kaymantex68/autocad_nagrev_vann_tatarstan/1.pdf

## Обогрев ванн

схема электрическая принципиальная пульта управления

Тамбов 2020г.
