kaymantex68/autocad_nagrev_vann_tatarstan/нагрев ванн.pdf

# Обогрев ванн

## схема электрическая принципиальная пульта управления

Тамбов 2020г.

1 | 2 | 3 | 4 | 5 | 6 | 7 | 8 | 9 | 10

Инв.N подл. Подпись и дата Взам.инв. N Формат А3 Изм Кол.уч Лист N док. Подп. Дата Лист Ввод ~380VA Wmax S кабеля 10мм2 Ванна I Индикация работа нагревателя I Индикация работа насоса I Ванна II Индикация работа нагревателя II Индикация работа насоса II Нагреватель 220VAC 12 кВт Насос 380VAC 0,75 кВт Нагреватель 220VAC 12 кВт Насос 380VAC 0,75 кВт Обогрев ванн 2

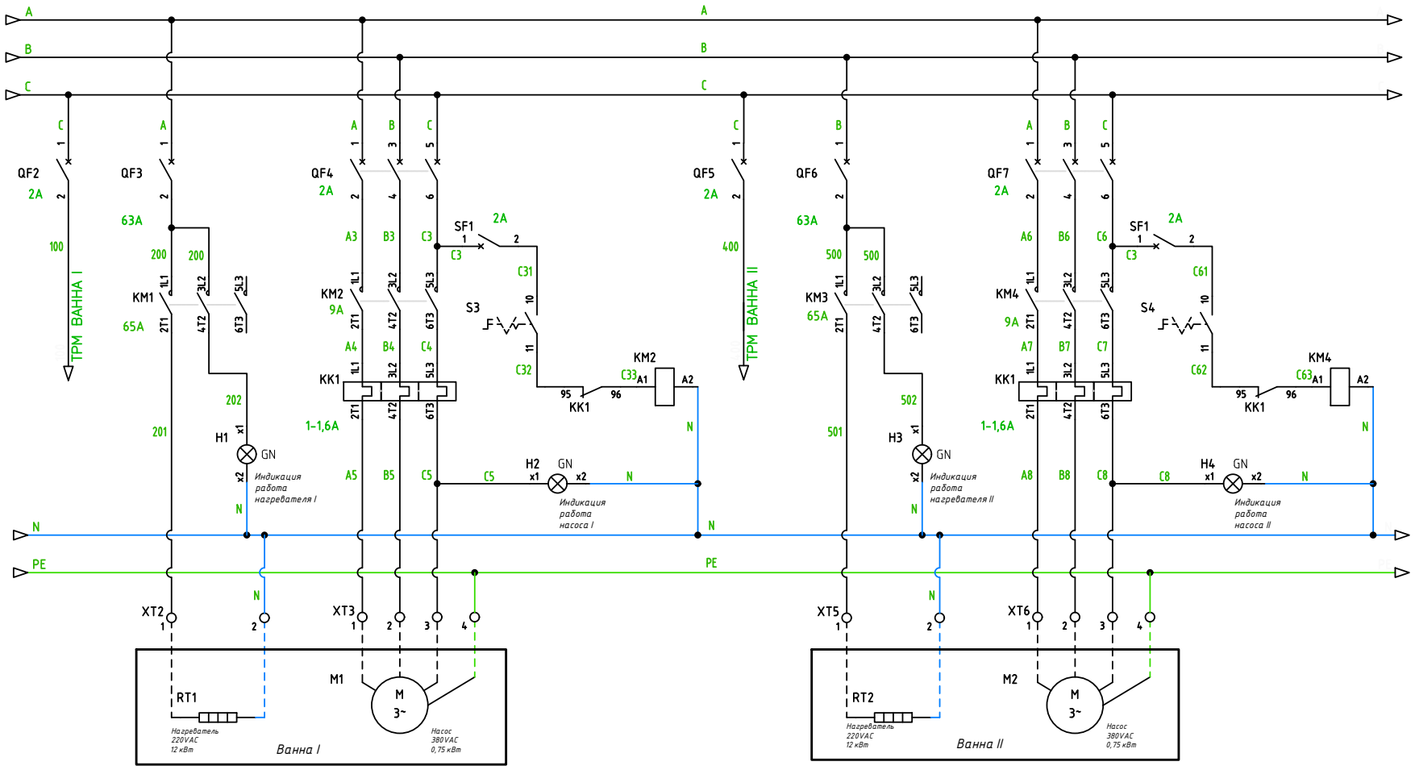
[picture p1: figure]

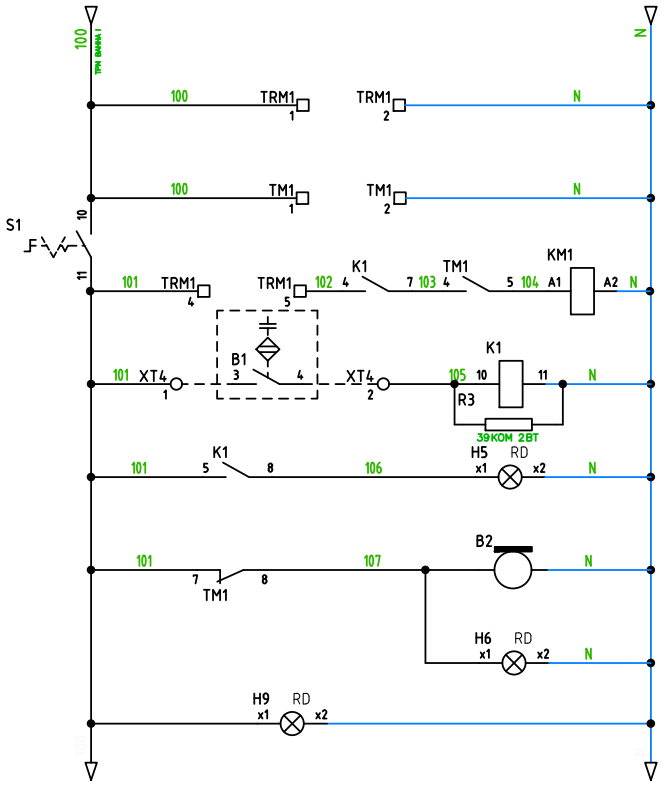
[picture p2: figure]
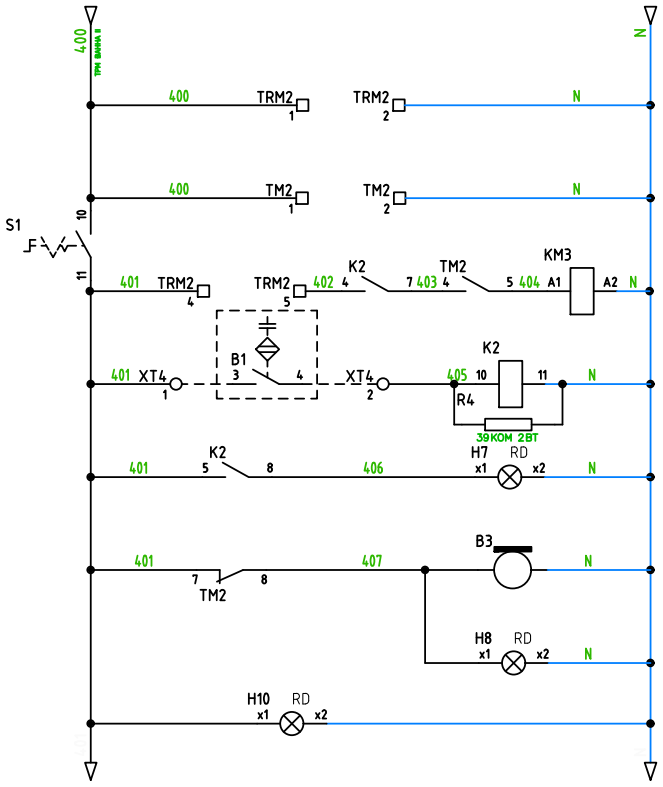
[picture p3: figure]

Инв.N подл. Подпись и дата Взам.инв. N Формат А3 Изм Кол.уч Лист N док. Подп. Дата Лист Питание: ТРМ 1 Питание: таймер 1 Нагрев: ванна 1 Емкостный датчик: ванна 1 Оповещение: уровень жидкости ванна 1 Звуковое оповещение: окончание работы Световое оповещение: окончание работы Ванна I Питание: ТРМ 2 Питание: таймер 2 Нагрев: ванна 2 Емкостный датчик: ванна 2 Оповещение: уровень жидкости ванна 2 Звуковое оповещение: окончание работы Световое оповещение: окончание работы Ванна II Обогрев ванн 3 Состояние: нагрев вкл/выкл Состояние: нагрев вкл/выкл

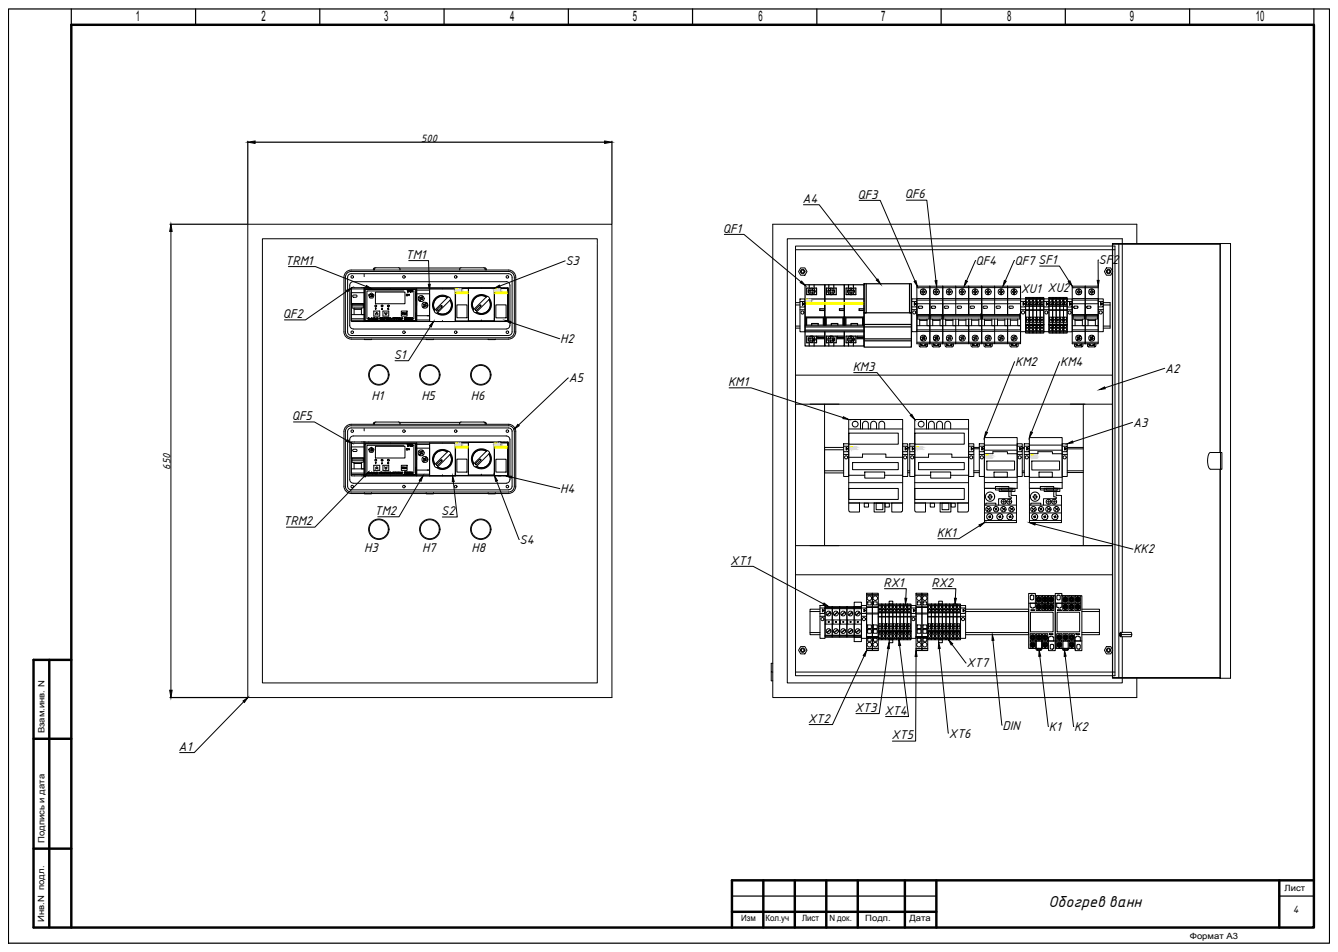
[picture p4: page 4]
650 500 Обогрев ванн 4

Инв.N подл. Подпись и дата Взам.инв. N Формат А3 Изм Кол.уч Лист N док. Подп. Дата Лист QF2QF5 TRM1 TRM2 TM1 TM2S1 S2 S4 S3 H4H2 H1 H3 H5H7 H6H8 XT1 XT2 XT3 XT4 RX1 XT5 XT6XT7 RX2 K1 K2 KM1 KM3 KM2 KM4 KK1 KK2 SF1 SF2 QF1 QF3 QF6 QF4 QF7XU1 XU2 A1 DIN A2 A3 A4 A5

Подп. Дата

Формат A4

Изм. | Кол.уч. | Лист Nдок.

Лист Инв.N подл. Подпись и дата Взам.инв. N Инв.N подл. Подпись и дата

Перечень материалов

Позиционные обозначения | Наименование | Кол-во | Eд.изм. | Примечание
A1 | Щит монтажный ЩМП 650х500х220 IP54 У2 металлический
ЩМП-3-0 | 1 | шт. A2 | Короб перфорированный RL6 40x40 серый QUADRO | 1 | м. A3 | Концевой стопор (ограничитель с маркировкой) на DIN-рейку | 18 | шт. A4 | Шина на DIN-рейку в корпусе (кросс-модуль) 3L+PEN 4х7 | 1 | шт. A5 | MT-WPC12 Крышка защитная на 12 модулей | 2 | шт. QF1 | Выключатель автоматический ВА47-100 3Р 80А 10кА С IEK | 1 | шт. QF3,QF6 | Выключатель автоматический ВА47-100 1Р 63А 10кА С IEK | 2 | шт. QF4,QF7 | Выключатель автоматический ВА47-29 3Р 3А 4,5кА С IEK | 2 | шт. SF1,SF2 | Выключатель автоматический ВА47-29 1Р 2А 4,5кА С IEK | 2 | шт. КМ1,КМ3 | Контактор КМИ-46512 65А 230В/АС3 1НО;1НЗ IEK | 2 | шт. КМ2,КМ4 | Контактор КМИ-10910 9А 230В/АС3 1НО IEK | 2 | шт. DIN | DIN-рейка 200см OMEGA 3 без отверстий | 1 | м. K1,K2 | Реле промежуточное РЭК77/3(LY3) 10А 24В АC IEK

Разъем розеточный модульный РРМ78/3(PYF11A) для
РЭК78/3(MY3) IEK | 2 | шт. XT1 | Клемма винтовая M10/10 10 мм.кв (ENT1SNA115120R1700) | 4 | шт. Клемма винтовая M10/10P 10мм.кв Земля (ENT1SNA165115R1000) | 1 | шт. XT2,XT5 | Клемма пружинная ST 6 мм2 серая Phoenix Contact | 4 | шт. Клемма пружинная ST 2,5 мм2 ж/з PE Phoenix Contact | 2 | шт. H1,H3,H5,H7 | Лампа AD-22DS сигнальная зеленая светодиодная 12В | 4 | шт. H2,H4 | Лампа сигнальная зеленая DIN 1P неон ЛС-47 | 4 | шт. H6,H8 | СИРЕНА AR-AD22-22SM | 2 | шт. QF1,QF5 | Выключатель автоматический ВА47-29 1Р 2А 4,5кА С IEK | 2 | шт. TRM1,TRM2 | ТРМ1-Д.У.Р | 2 | шт. TM1,TM2 | Реле задержки выключения ORT 2 контакта 230В AС IEK | 2 | шт. S1,S2,S3,S4 | Переключатель LAY5-BD25 2 позиции I-0 стандартная ручка | 4 | шт. Обогрев ванн | 5
