kaymantex68/autocad_nagrev_vann_tatarstan/(list of files, cad)

Other CAD files:
project.dwg
