kaymantex68/autocad_nagrev_vann_tatarstan/5.pdf

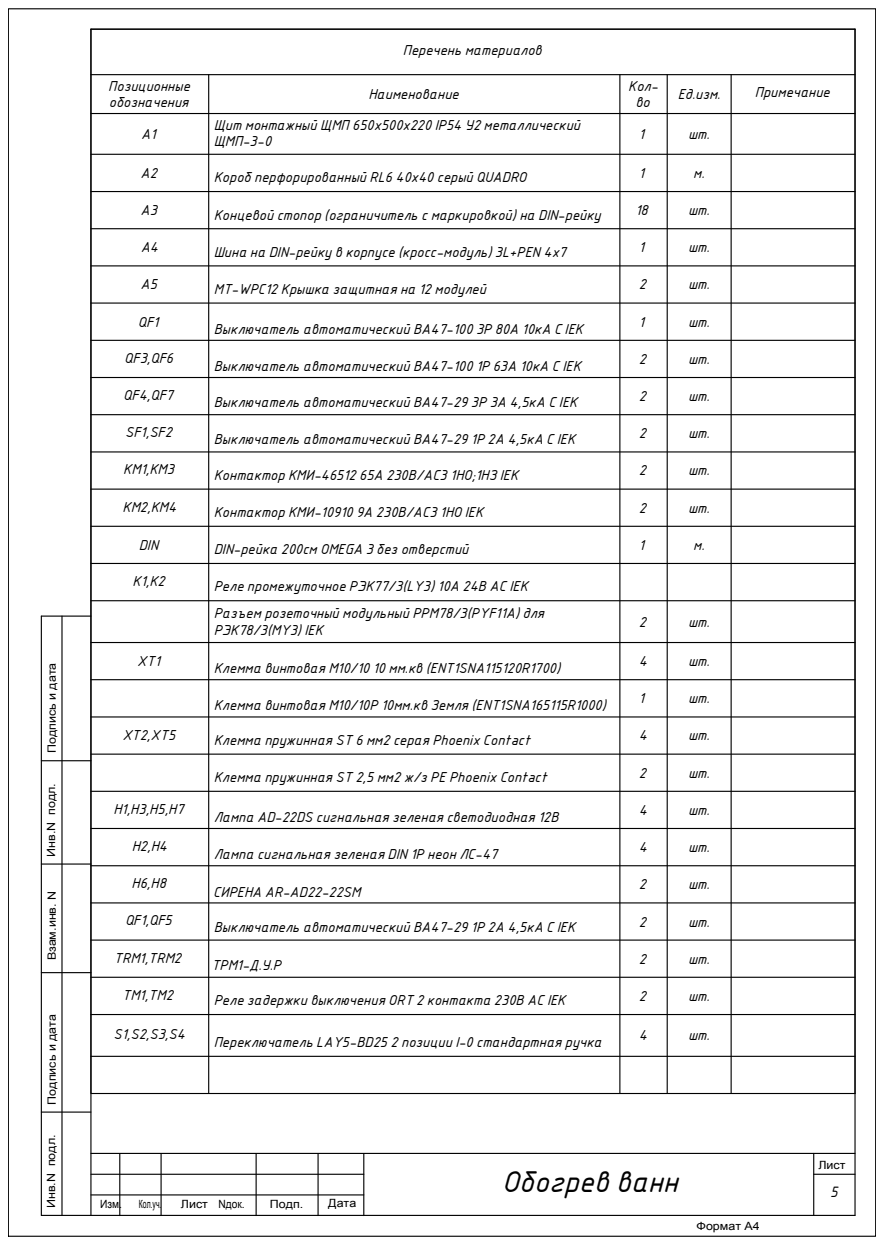
[picture p5: page 1]
Формат A4; Изм.; Кол.уч.; Лист Nдок.; Перечень материалов; ЩМП-3-0; Короб перфорированный RL6 40x40 серый QUADRO; Концевой стопор (ограничитель с маркировкой) на DIN-рейку; Шина на DIN-рейку в корпусе (кросс-модуль) 3L+PEN 4х7; MT-WPC12 Крышка защитная на 12 модулей; Выключатель автоматический ВА47-100 3Р 80А 10кА С IEK; Выключатель автоматический ВА47-100 1Р 63А 10кА С IEK; Выключатель автоматический ВА47-29 3Р 3А 4,5кА С IEK; Выключатель автоматический ВА47-29 1Р 2А 4,5кА С IEK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

Позиционные обозначения | Наименование | Кол-во | Eд.изм. | Примечание

A1 | Щит монтажный ЩМП 650х500х220 IP54 У2 металлический

Разъем розеточный модульный РРМ78/3(PYF11A) для

Лист Инв.N подл. Подпись и дата Взам.инв. N Инв.N подл. Подпись и дата
