kaymantex68/autocad_nagrev_vann_tatarstan/(commit log)

2020-10-21 офис нагрев ванн татарстан вер.1
    [project.dwg]
2020-11-08 office dwg+pdf
    [project.dwg]
